lazycurren/Room-AC-Control/Hardware/ESP32-DOIT-DEV-KIT-v1/ESP32-DOIT-DEV-KIT-v1-pinout-mischianti.png

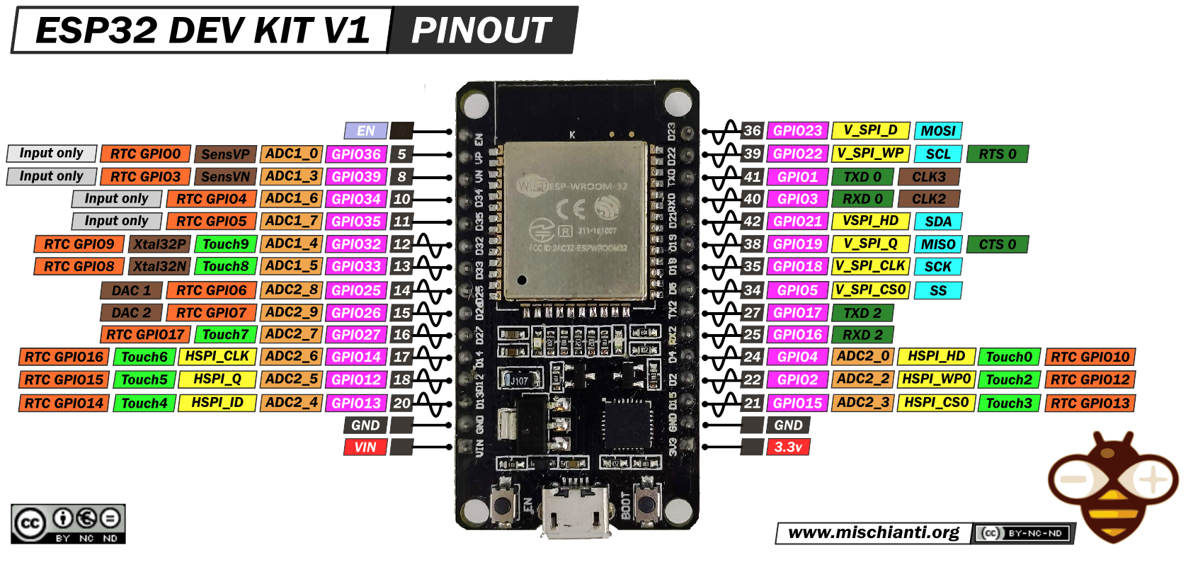
Hardware/ESP32-DOIT-DEV-KIT-v1/ESP32-DOIT-DEV-KIT-v1-pinout-mischianti.png
