lazycurren/Room-AC-Control/image.jpg

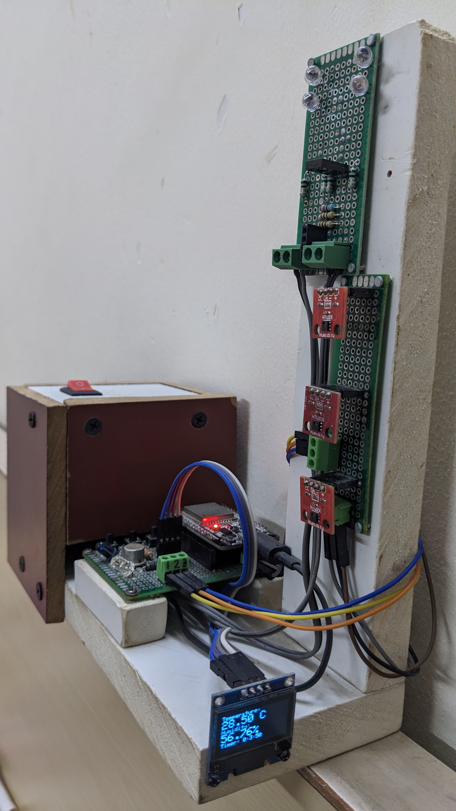
image.jpg
