lazycurren/Room-AC-Control/Drivers/readme.txt

You may or may not need these drivers depending on your hardware/software setup. Only try to install these if something doesn't work for you.
