lazycurren/Room-AC-Control/Main Program/readme.txt

Power the ESP32 using a micro USB cable. This is the main program.
