lazycurren/Room-AC-Control/Misc Programs/AC Remote Signal Receiver/sketch/Arduino IDE settings.txt

Board: "Arduino Mega or Mega 2560"

Processor: "ATmega2560 (Mega 2560)"

Programmer: "AVRISP mkII"

Serial Monitor: 57600 baud
