lazycurren/Room-AC-Control/Hardware/128x64 4pin I2C OLED Display.pdf

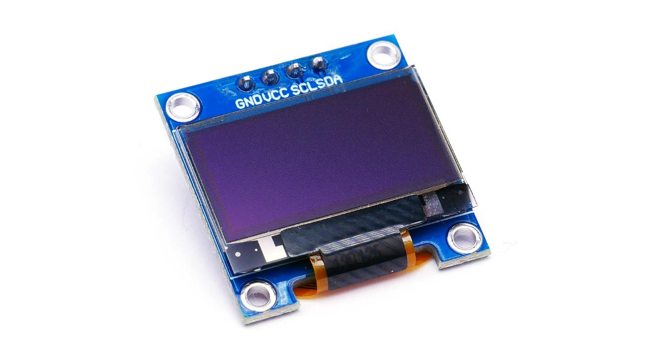
[picture p3: figure]

(Amazon) Generic 4pin I2C OLED Display Module (https://www.amazon.in/gp/product/B01GNZEM22/ref=ppx_yo_dt_b_search_asin_title?ie=UTF8&psc=1)

Adafruit Library and Documentation for this display (https://github.com/adafruit/Adafruit_SSD1306)
