lazycurren/Room-AC-Control/Main Program/sketch/circuit diagram.png

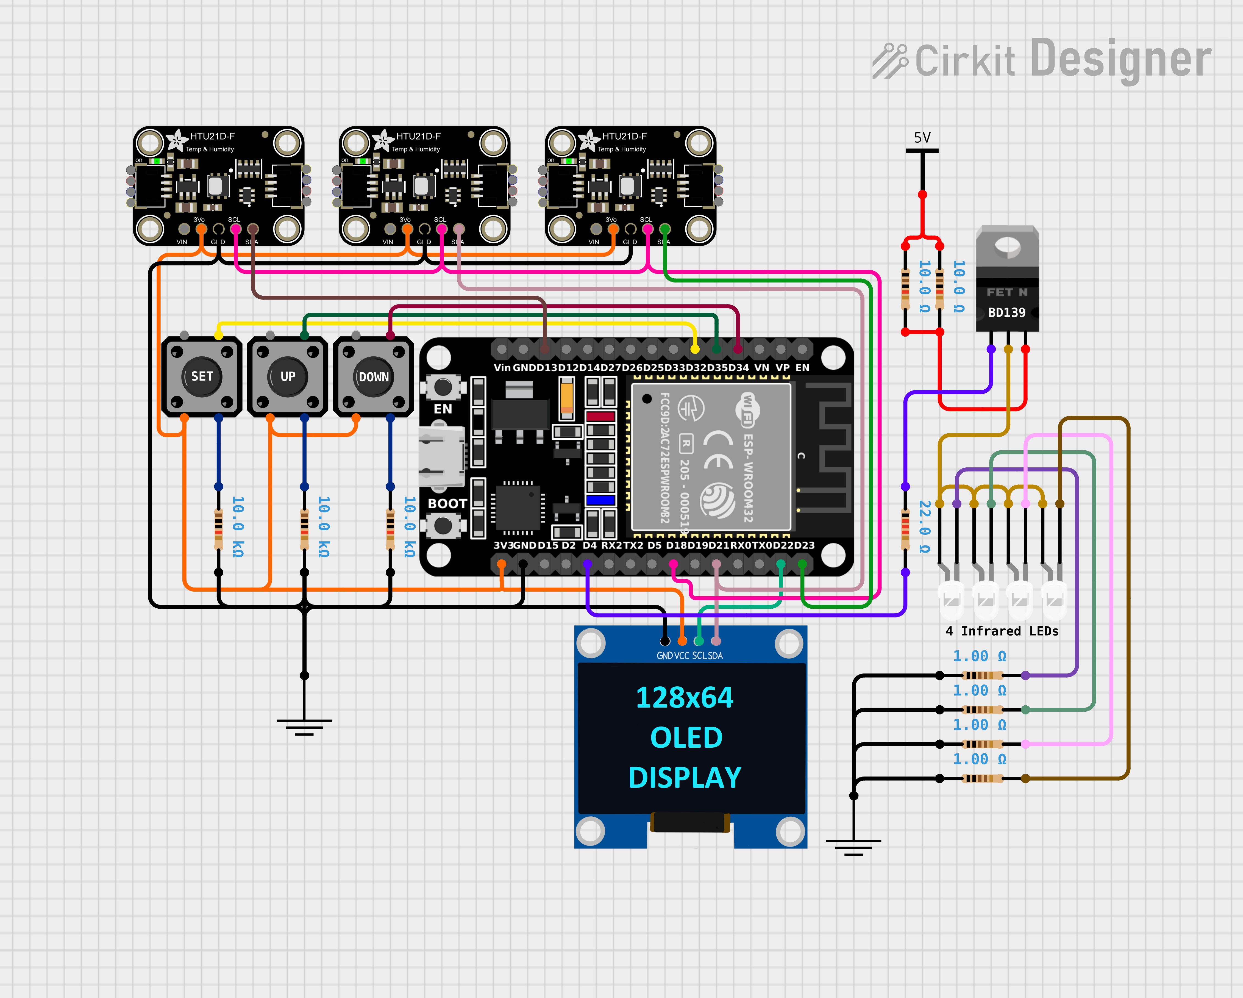
Main Program/sketch/circuit diagram.png
