lazycurren/Room-AC-Control/Misc Programs/AC Remote Signal Receiver/sketch/circuit diagram.png

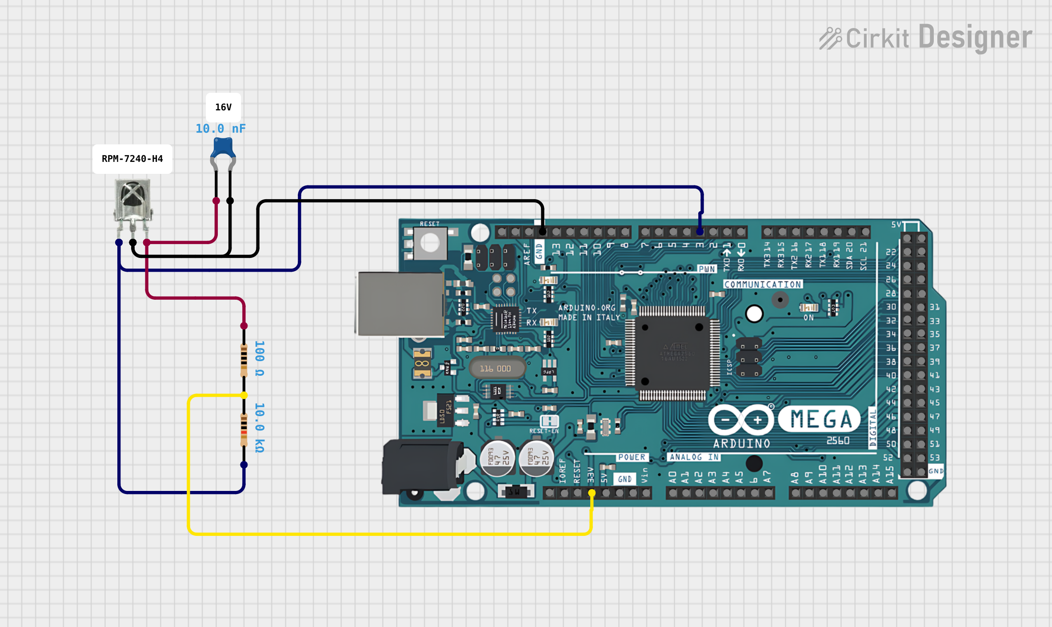
Misc Programs/AC Remote Signal Receiver/sketch/circuit diagram.png
