lazycurren/Room-AC-Control/Misc Programs/Infrared Output Power/sketch/PSpice circuit diagram/pspice1.PNG

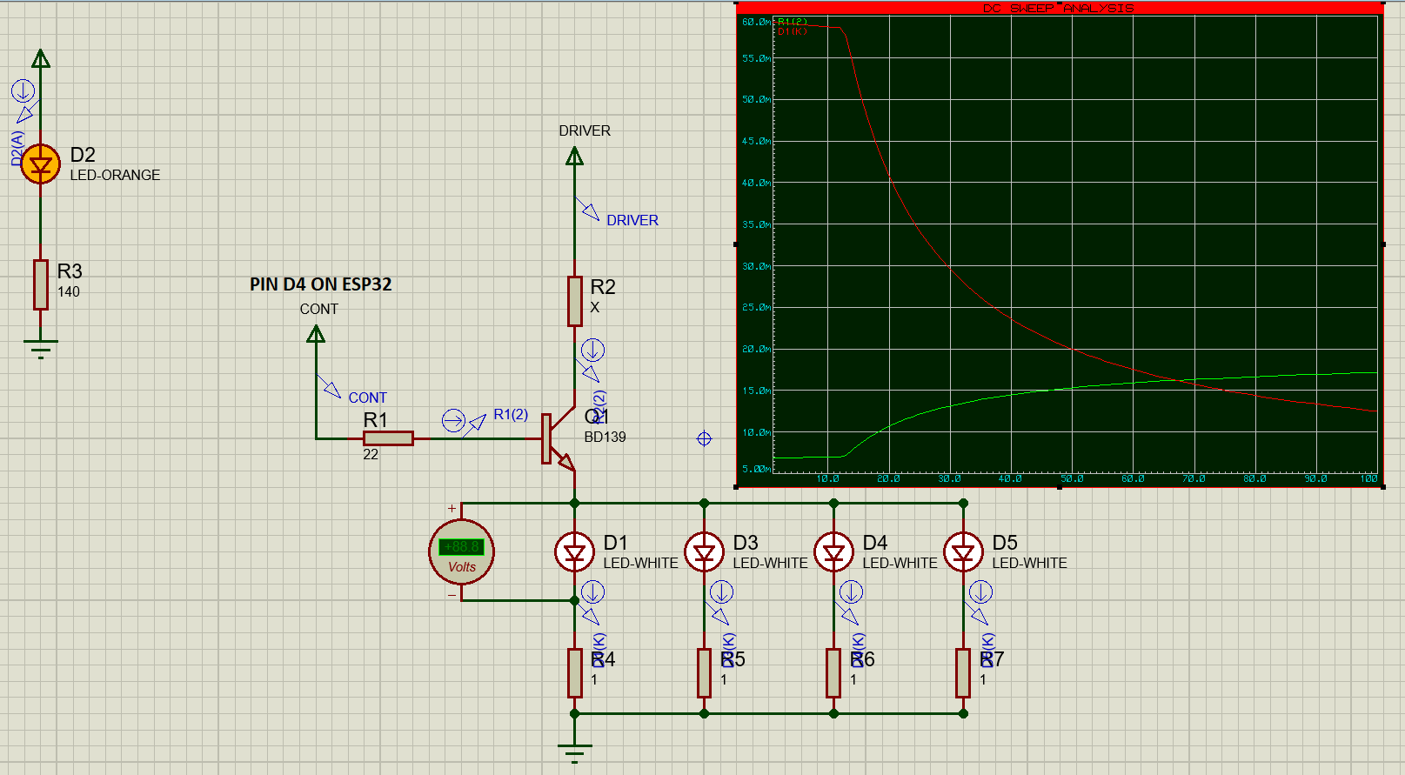
Misc Programs/Infrared Output Power/sketch/PSpice circuit diagram/pspice1.PNG
