lazycurren/Room-AC-Control/Misc Programs/Infrared Output Power/sketch/PSpice circuit diagram/pspice2.PNG

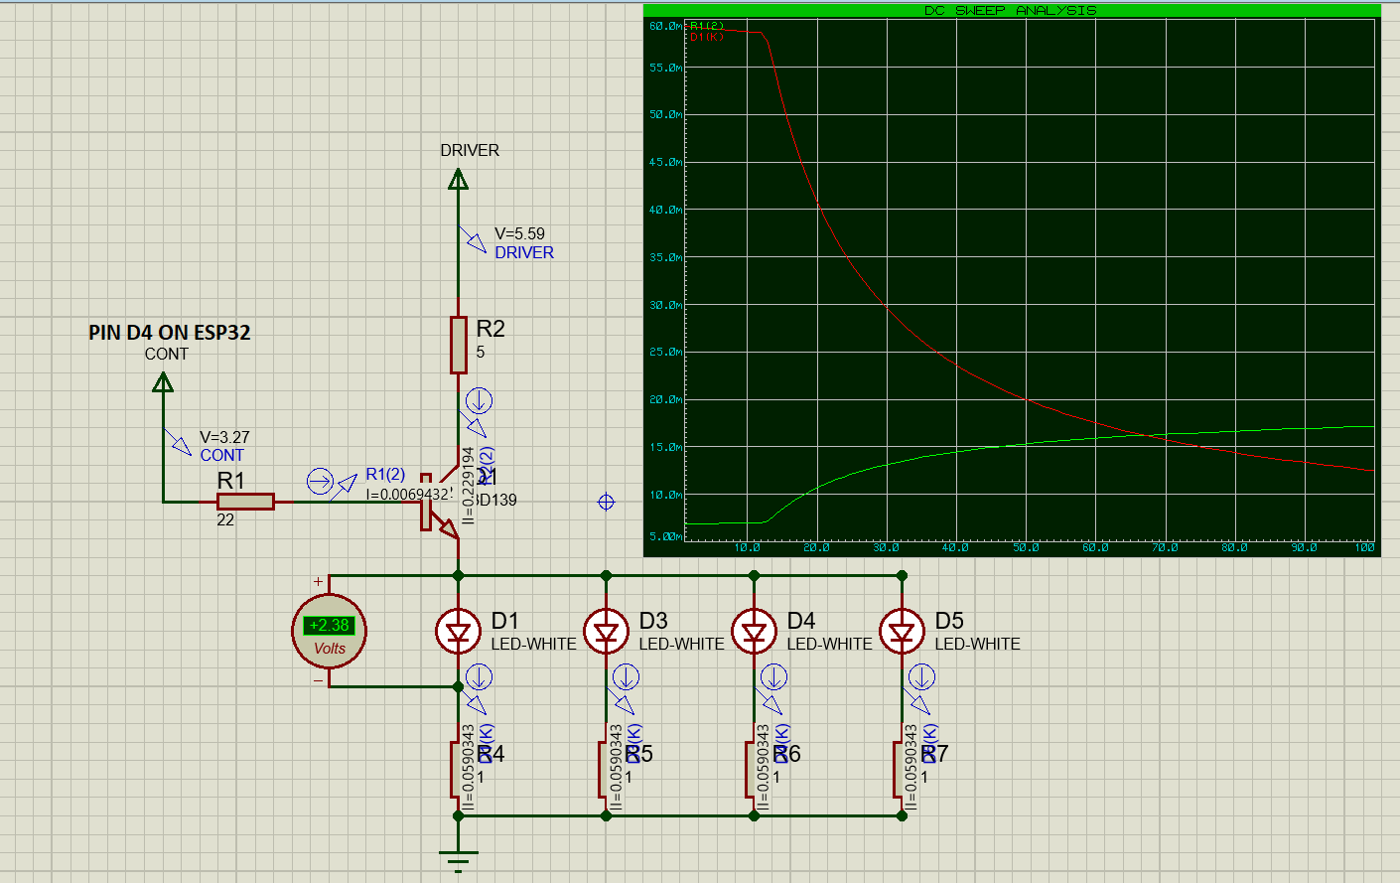
Misc Programs/Infrared Output Power/sketch/PSpice circuit diagram/pspice2.PNG
