lazycurren/Room-AC-Control/(list of files, drawings)

Other design files:
Misc Programs/Infrared Output Power/sketch/PSpice circuit diagram/IR-POWER-DESIGN.pdsprj
