lazycurren/Room-AC-Control/Main Program/sketch/controller_main/ircodes.h

#ifndef IRCODES_H
#define IRCODES_H

uint16_t rawON[279]=
{
  9060, 4432, 708, 1596, 712, 1592, 716, 488, 716, 1592, 712, 1592, 716, 488, 716, 488, 712, 496, 712, 492, 712, 1596, 708, 496, 712, 1592, 712, 492, 716, 492, 712, 492, 712, 496, 708, 496, 708, 496, 708, 496, 712, 496, 708, 496, 708, 1596, 712, 1596, 708, 496, 708, 496, 708, 496, 712, 496, 708, 496, 708, 1596, 708, 496, 712, 1596, 708, 496, 708, 496, 708, 1596, 712, 496, 708, 19908, 728, 476, 724, 480, 720, 488, 716, 488, 716, 488, 716, 492, 712, 492, 712, 492, 712, 496, 708, 496, 708, 496, 712, 496, 708, 496, 708, 496, 708, 1600, 708, 1596, 712, 492, 712, 496, 708, 496, 712, 492, 708, 500, 708, 496, 708, 496, 708, 496, 708, 500, 704, 500, 704, 500, 704, 504, 704, 1600, 704, 1600, 708, 500, 704, 1600, 708, 39884, 9052, 4428, 712, 496, 708, 496, 708, 496, 712, 496, 708, 496, 708, 496, 708, 496, 708, 500, 704, 500, 708, 500, 704, 500, 704, 500, 704, 504, 704, 500, 704, 500, 704, 504, 700, 504, 704, 500, 704, 504, 700, 504, 704, 500, 704, 504, 700, 504, 700, 504, 704, 500, 704, 504, 700, 504, 700, 504, 700, 508, 700, 1604, 704, 500, 704, 1600, 708, 500, 704, 1600, 708, 496, 708, 19904, 732, 476, 724, 480, 720, 488, 716, 488, 716, 488, 716, 492, 712, 492, 712, 492, 712, 496, 708, 496, 708, 496, 708, 496, 712, 496, 708, 496, 708, 500, 708, 496, 708, 496, 708, 500, 704, 500, 704, 500, 708, 496, 708, 500, 704, 500, 704, 500, 704, 500, 704, 504, 700, 504, 704, 500, 704, 504, 700, 1604, 704, 500, 704, 1600, 708
};

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
};

#endif
