lazycurren/Room-AC-Control/Main Program/sketch/controller_main/wserialmonitor.hpp

#ifndef WSERIALMONITOR_H
#define WSERIALMONITOR_H

#include <WiFi.h>
#include <AsyncTCP.h>
#include <ESPAsyncWebServer.h>
#include <WebSerial.h>

AsyncWebServer server(80);
const char* ssid = "Karan"; // Your WiFi SSID
const char* password = "gusnhde321"; // Your WiFi Password

void recvMsg(uint8_t *data, size_t len){
  WebSerial.println("Received Data...");
  String d = "";
  for(int i=0; i < len; i++){
    d += char(data[i]);
  }
  WebSerial.println(d);
}

void wlansetup() {
    WiFi.mode(WIFI_STA);
    WiFi.begin(ssid, password);
    if (WiFi.waitForConnectResult() != WL_CONNECTED) {
        //Serial.printf("WiFi Failed!\n");
        return;
    }
    //Serial.print("IP Address: ");
    //Serial.println(WiFi.localIP());
    // WebSerial is accessible at "<IP Address>/webserial" in browser
    WebSerial.begin(&server);
    /* Attach Message Callback */
    WebSerial.msgCallback(recvMsg);
    server.begin();
}


#endif
